iwonder77/diorama-pads/docs/Diorama.pdf

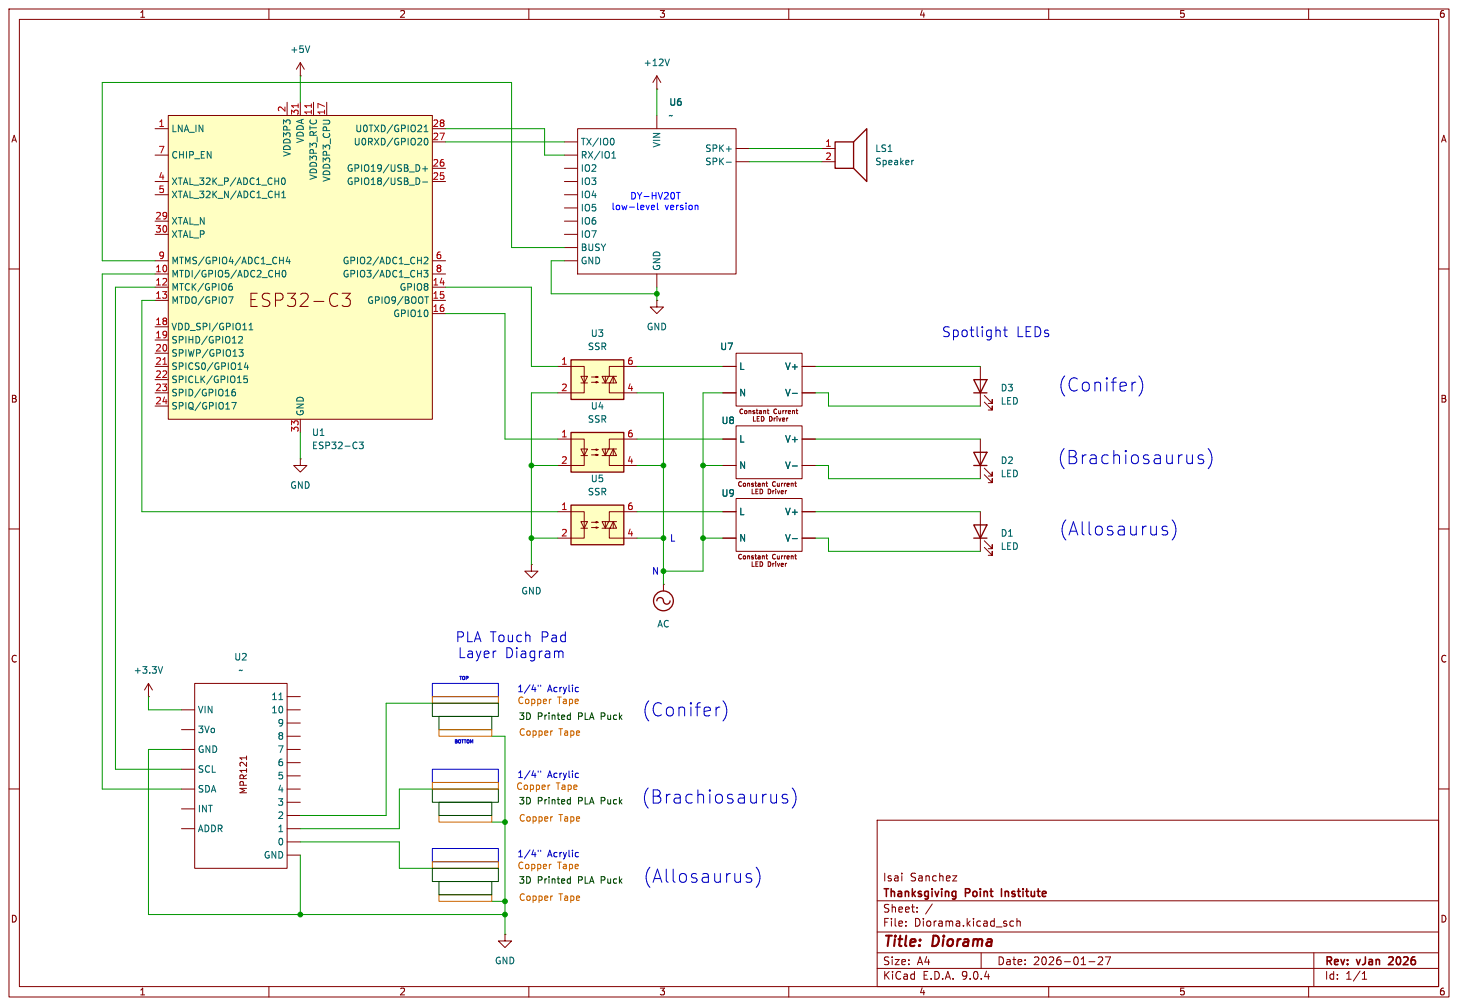
[picture p2: page 1]

Isai Sanchez AC
Copper Tape
3D Printed PLA Puck Copper Tape
