iwonder77/diorama-pads/(commit log)

2025-11-26 add: new class to handle UART communication with DY-HV20T
2025-12-02 update: add busy pin reading logic for basic state machine (2 states, IDLE, and PLAYING)
2025-12-02 refactor: add an App class to handle which type of runtime we want the system to run, currently only debug and prod
2025-12-02 update: modify first and second level filter samples (FFI and SFI)
2025-12-02 really messy rn but I had to commit, I am reverting back to hardcoding global cdc/cdt values (still have yet to figure out how to configure individual CDCx/CDTx electrode values, but that's next), re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
    [App.cpp]
2025-12-03 add new files to replace previous MyMPR121 class, these are much more organized/readable, and use the new Config file for certain configuration constants
    [MPR121.cpp, MPR121.h]
2025-12-03 remove definition macro for busy pin
2025-12-03 add new touched() method with our very own hysteresis and filtering and threshold detection
2025-12-04 updated state machine to 1. Create timestamp for when sound command was sent 2. Wait for a brief period in PLAYING state to ensure busy pin is asserted (pulled low) 3. Include a safety mechanism to f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
    [App.cpp]
2025-12-04 implement setAutoconfig() method to tune individual electrode CDCx/CDTx value (overriding global CDC/CDT fields set before when autoconfig variable is true)
2025-12-08 add better comments to file plus one more serial print statement during PLAYING state
2025-12-08 add smooth delta print statements to dumpCapData method and removed them from touched() method
2025-12-15 feat(spotlight): added constants for pin count and pin array
2025-12-15 feat(spotlight): add Spotlight switching logic when audio begins to play and at end of COOLDOWN period
2025-12-17 update pin numbers for spotlight switching with SSRs
2026-04-16 add constant defining how long a spotlight should turn on with correct conventions and data type size
    [Config.h]
2026-04-16 removed all instances of AudioPlayer, fixed main run() loop to allow multiple spotlights on at once with timer for each
    [App.cpp]
